rarepair/rocketeer/README.md

# rocketeer
A model rocket ignitor with adjustable current source and continuity checking. Capable of sourcing up to 10A from 4S lithium pack.
