rarepair/rocketeer/cad/Silkscreen Art/moon_art.bmp

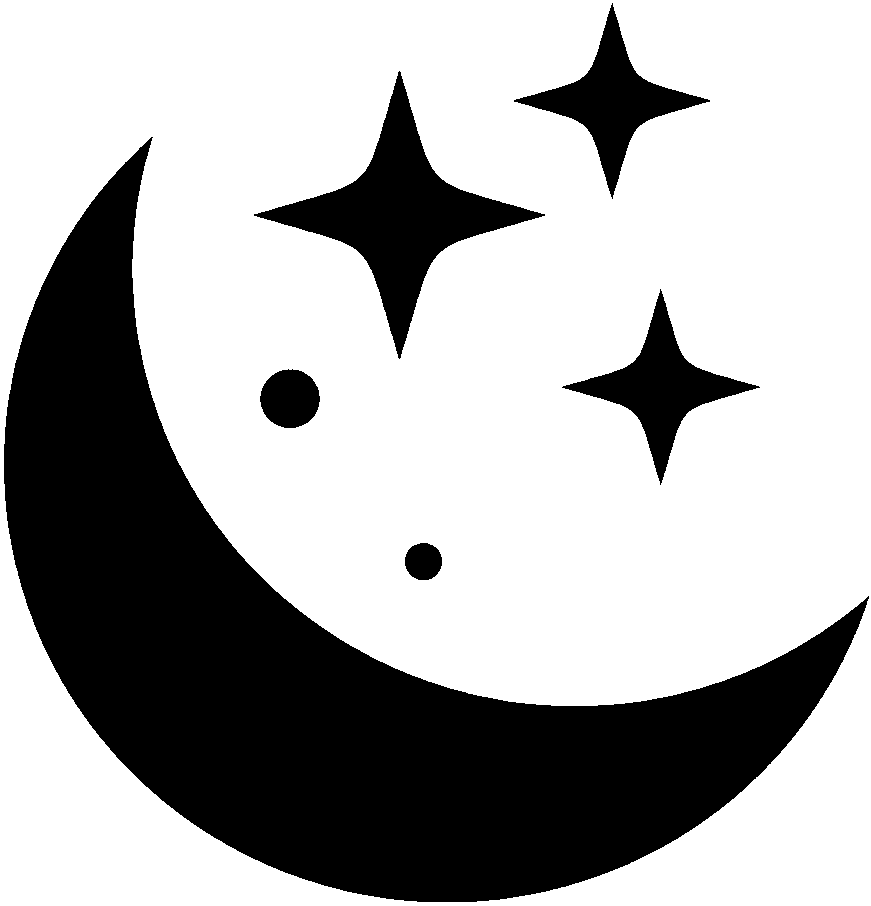
cad/Silkscreen Art/moon_art.bmp
