rarepair/rocketeer/cad/Silkscreen Art/rocket_art.bmp

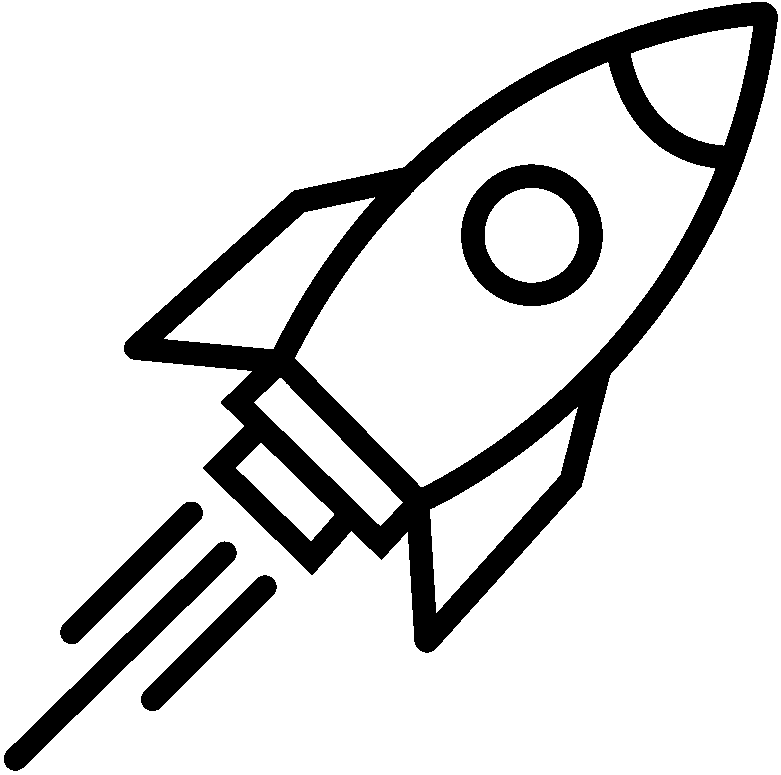
cad/Silkscreen Art/rocket_art.bmp
