rarepair/rocketeer/cad/Silkscreen Art/saturn_art.bmp

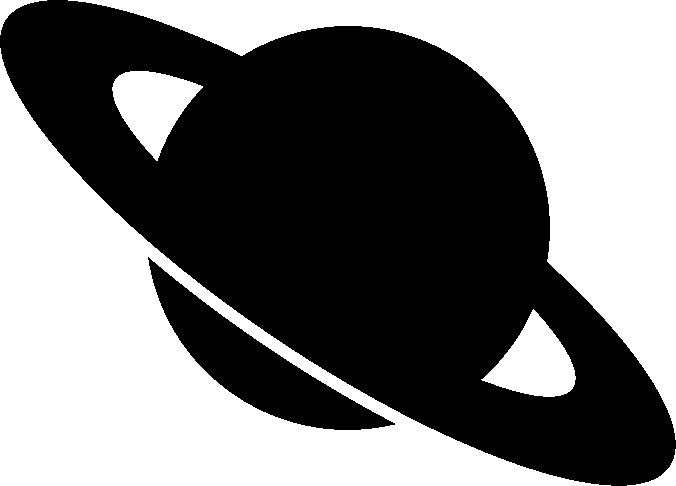
cad/Silkscreen Art/saturn_art.bmp
