rarepair/rocketeer/cad/Silkscreen Art/shooting_star_art.bmp

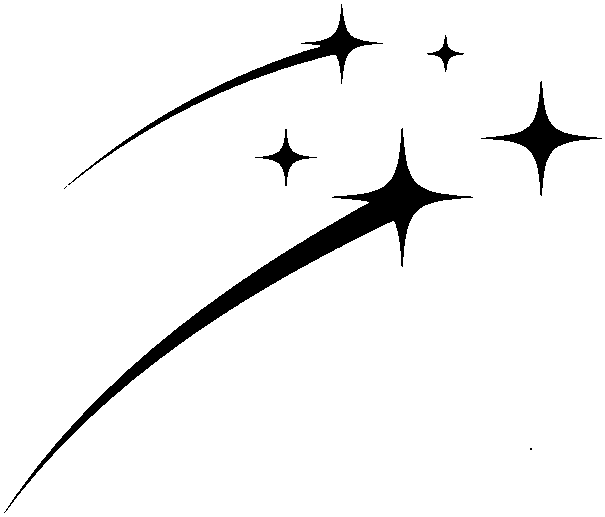
cad/Silkscreen Art/shooting_star_art.bmp
