rarepair/rocketeer/cad/Silkscreen Art/stars_art.bmp

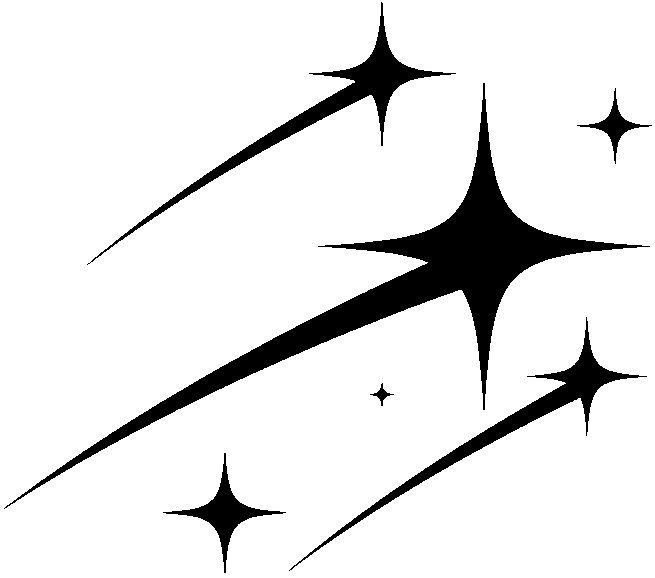
cad/Silkscreen Art/stars_art.bmp
