rarepair/rocketeer/bom/Bill of Materials-Rocket_Engine_Igniter.xlsx

Designator | Manufacturer | Part Number | LibRef | Quantity
U4 | Texas Instruments | SN74LVC1G17DCKR | SN74LVC1G17 | 1
U3 | Texas Instruments | LM7321MAX/NOPB | LM7321 | 1
U2 | Texas Instruments | TPS7A2425DBVR | TPS7A2425DBVR | 1
U1 | Monolithic Power Systems | MP2659-0000 | MP2659 | 1
SW3 | E-Switch | PV5S24019 | SW_PUSHBUTTON_PV5S24019 | 1
SW2 | Multicomp | MCR13-28A-01 | SW_TOGGLE_MCR13-28A-01 | 1
SW1 | Adam Tech | SW-R-K1-A | SW_KEYLOCK_SW-R-K1-A | 1
R28 | Stackpole Electronics Inc | RMCF0805FT1R00 | RES_0805_1R0 | 1
R23 | Stackpole Electronics | BR3FB50L0 | RES_BR3FB50L0_0R05_1% | 1
R21 | Bourns Inc. | PTV09A-4015F-B102 | POT_1K_PTV09A-4015F-B102 | 1
R20, R22, R26 |  |  | RES_0603_0R0 | 3
R17 | Vishay Dale | CRCW0805560RFKEAHP | RES_0805_560R | 1
R15 | Stackpole Electronics Inc | RMCF0603FT2K40 | RES_0603_2K4 | 1
R14, R16 | Stackpole Electronics Inc | RMCF0603FT1K00 | RES_0603_1K | 2
R10 | Stackpole Electronics Inc | RMCF0603FG15K0 | RES_0603_15K | 1
R9 |  |  | RES_0603_NOSTUFF | 1
R8, R13, R25 | Stackpole | RMCF0603FT100K | RES_0603_100K | 3
R6 | Stackpole Electronics Inc | RMCF0603FG150K | RES_0603_150K | 1
R5, R7 | Stackpole Electronics Inc. | RMCF0603FT95K3 | RES_0603_95K3 | 2
R3 | Stackpole Electronics Inc | RMCF0603FT330R | RES_0603_330R | 1
R2, R18, R24, R27 | Stackpole Electronics Inc | RMCF0603FT4K02 | RES_0603_4K02 | 4
R1, R4, R11, R12, R19 | Stackpole Electronics Inc | RMCF0603FT10K0 | RES_0603_10K | 5
Q5 | ANBON SEMICONDUCTOR (INT'L) LIMITED | AS2302 | NFET_AS2302 | 1
Q4 | Vishay | IRFP9140PBF | PFET_IRFP9140 | 1
Q3 | Diodes Incorporated | DMP610DL-7 | PFET_DMP610DL | 1
Q1, Q2 | Vishay Siliconix | SIS413DN-T1-GE3 | PFET_SIS413DN | 2
L1 | Pulse Electronics | AMRM00101040220MA1 | IND_AMRM00101040220MA1_22U0 | 1
J4 | Cal Test Electronics | CT3151SP-0 | CONN_BANANA_BLK_CT3151SP-2_1 | 1
J3 | Cal Test Electronics | CT3151SP-2 | CONN_BANANA_RED_CT3151SP-2 | 1
J2 | AMASS | XT30PW-M | CONN_PLUG_XT30PW-M | 1
J1 | CUI Devices | PJ-037A | CONN_BARREL_PLUG_PJ-037A | 1
D10 | ON Semiconductor | RB520S30T5G | DIODE_RB520S30T5G | 1
D7 | Würth Elektronik | 150141RS73100 | LED_RED_150141RS73100 | 1
D6 | Würth Elektronik | 150141GS73100 | LED_GREEN_150141GS73100 | 1
D5, D8, D9 | Diodes Incorporated | SMAJ20AQ-13-F | DIODE_TVS_20V_UNIDIR | 3
D4 | Würth Elektronik | 150141AS73100 | LED_AMBER_150141AS73100 | 1
D3 | Würth Elektronik | 150141BS73100 | LED_BLUE_150141BS73100 | 1
D2 | Diodes Incorporated | SMAJ33AQ-13-F | DIODE_TVS_33V_UNIDIR | 1
D1 | Diodes Incorporated | B240AE-13 | DIODE_SCHOTTKY_40V_2A | 1
C13 | Yageo | CC0805KKX5R5BB106 | CAP_0805_10uF | 1
C11 | Samsung Electro-Mechanics | CL10B103KB8NNNC | CAP_0603_10nF | 1
C10 | KYOCERA AVX | KGM15AR71H102KT | CAP_0603_1nF | 1
C9 | Samsung Electro-Mechanics | CL10B225KP8NNNC | CAP_0603_2.2uF | 1
C5, C12 | Samsung Electro-Mechanics | CL31A106MBHNNNE | CAP_1206_10uF | 2
C4, C8 | Samsung Electro-Mechanics | CL10B105KA8NNNC | CAP_0603_1uF | 2
C3 | Würth Elektronik | 860020572006 | CAP_RADIAL_47uF | 1
C2, C6, C7 | Samsung Electro-Mechanics | CL10B104KB8NNWC | CAP_0603_100nF | 3
C1 | Samsung Electro-Mechanics | CL31B225KBHNFNE | CAP_1206_2.2uF | 1
