rarepair/rocketeer/stp/Rocket_Engine_Igniter.step

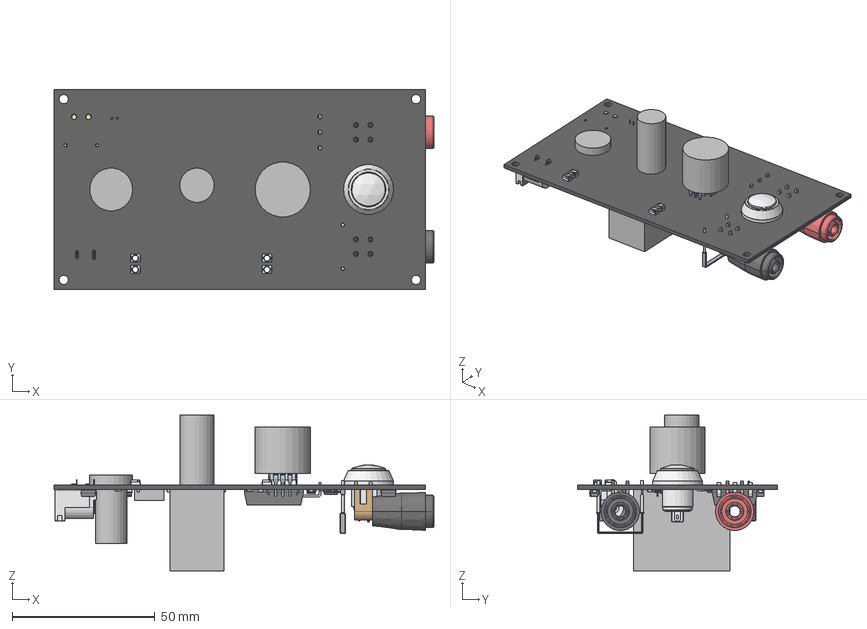
[picture p6: CAD file, 2025-01-13]
stp/Rocket_Engine_Igniter.step
132.9 x 70.0 x 54.4 mm
SOT-353
User Library-SOIC-8-1
User Library-SOT-23-5_pin_SOT_sot-23-6_1 x 5
User Library-SOT-23-5_body_sot23-6_1
Extruded x 3
SW_PUSHBUTTON_PV5S24019
RES_0603 x 22
RES_BR3FB50L0_0R05_1%
RES_0805 x 3
SOT-23-3 x 2
PFET_POWERPAK_1212-8 x 2
CONN_BANANA_BLK_CT3151SP-0
CONN_BANANA_RED_CT3151SP-2
CONN_PLUG_XT30PW-M
CONN_BARREL_PLUG_PJ-037A
SOD-523
FilletPin1 x 5
FilletPin2 x 5
CAP_1206 x 3
CAP_0603 x 8
POT_PTV09A-4x15F-xxxx
CAP_RADIAL_5MMx11MM
housing x 4
cover x 4
base x 8
