rarepair/rocketeer/sch/Rocket_Engine_Igniter.pdf

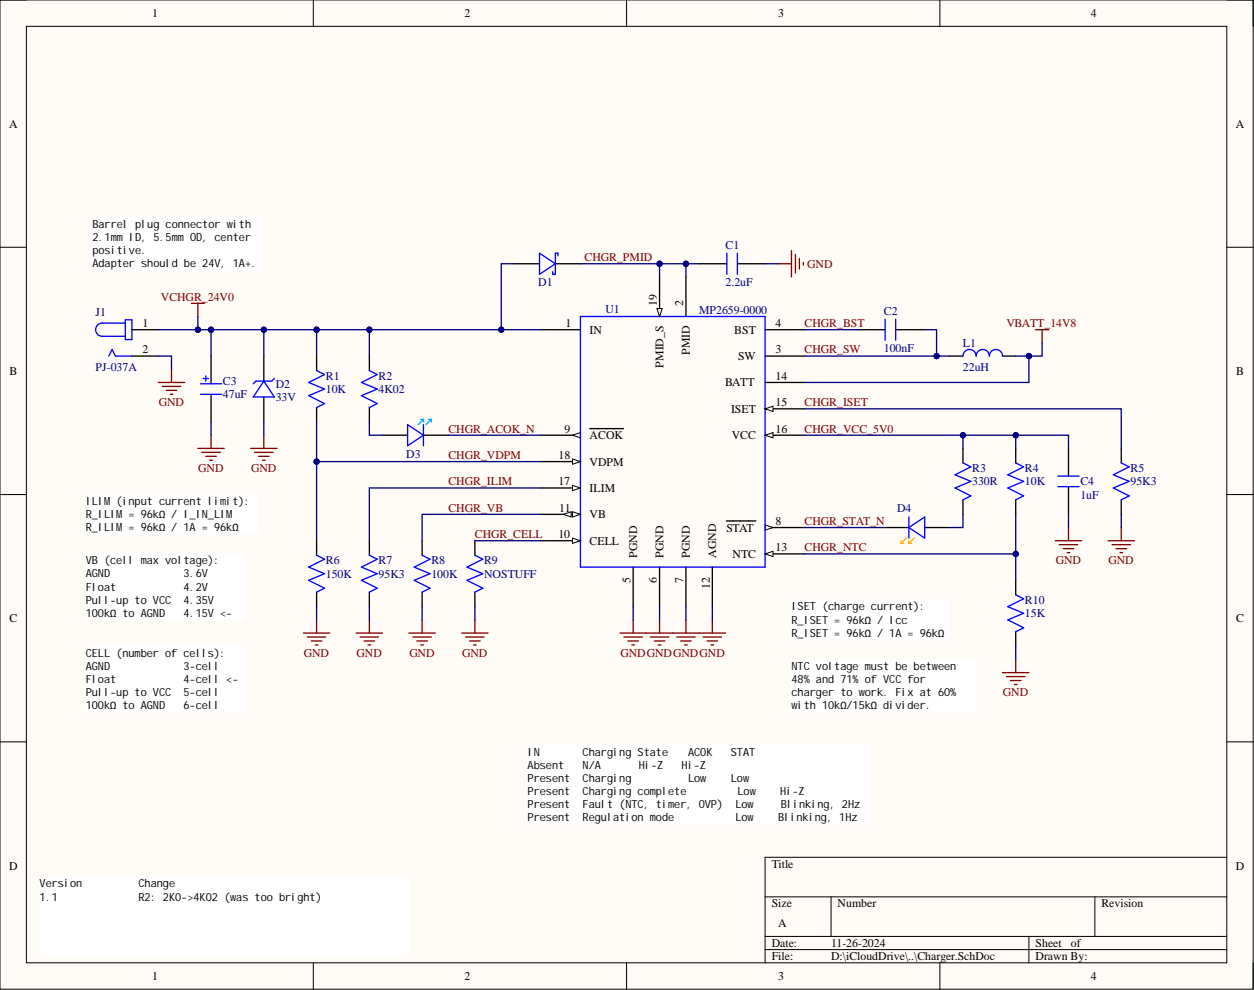
[picture p7: page 1]

Barrel plug connector with
2.1mm ID, 5.5mm OD, center
positive.
Adapter should be 24V, 1A+.

3 | CHGR_SW 100nF

CHGR_ILIM | | ILIM 17

CHGR_VB | 1 1

CHGR_CELL | | CELL 10

VB (cell max voltage):
Pull-up to VCC 4.35V

CELL (number of cells):
Pull-up to VCC 5-cell

NTC voltage must be between
48% and 71% of VCC for
charger to work. Fix at 60%
with 10k

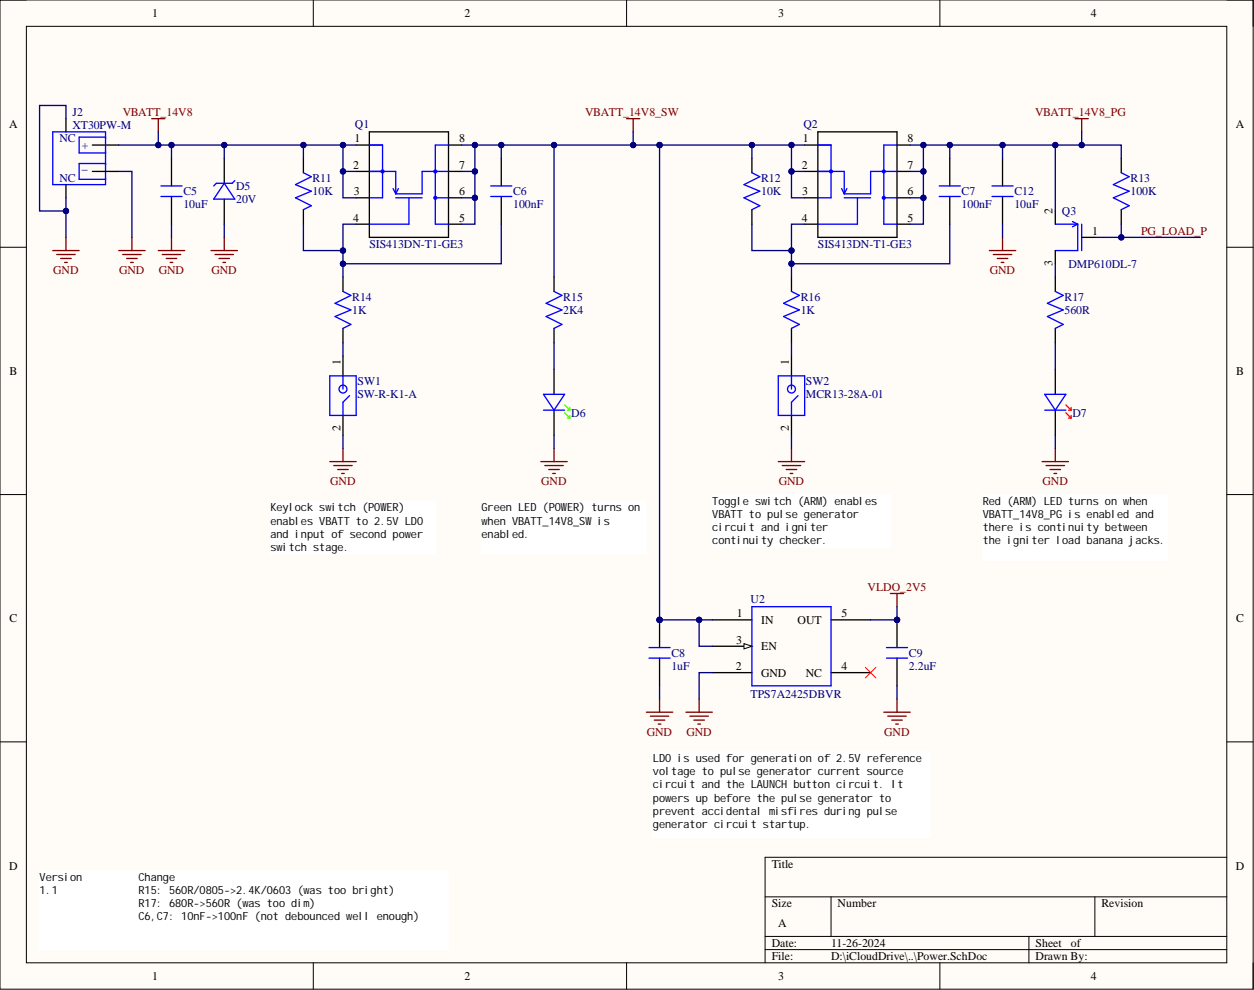
[picture p8: page 2]

Keylock switch (POWER)
enables VBATT to 2.5V LDO
and input of second power
switch stage.

Green LED (POWER) turns on
when VBATT_14V8_SW is
enabled.

Toggle switch (ARM) enables
VBATT to pulse generator
circuit and igniter
continuity checker.

Red (ARM) LED turns on when
VBATT_14V8_PG is enabled and
there is continuity between
the igniter load banana jacks.

LDO is used for generation of 2.5V reference
voltage to pulse generator current source
circuit and the LAUNCH button circuit. It
powers up before the pulse generator to
prevent accidental misfires during pulse
generator circuit startup.

R17: 680R->560R (was too dim)
C6,C7: 10nF->100nF (not debounced well enough)

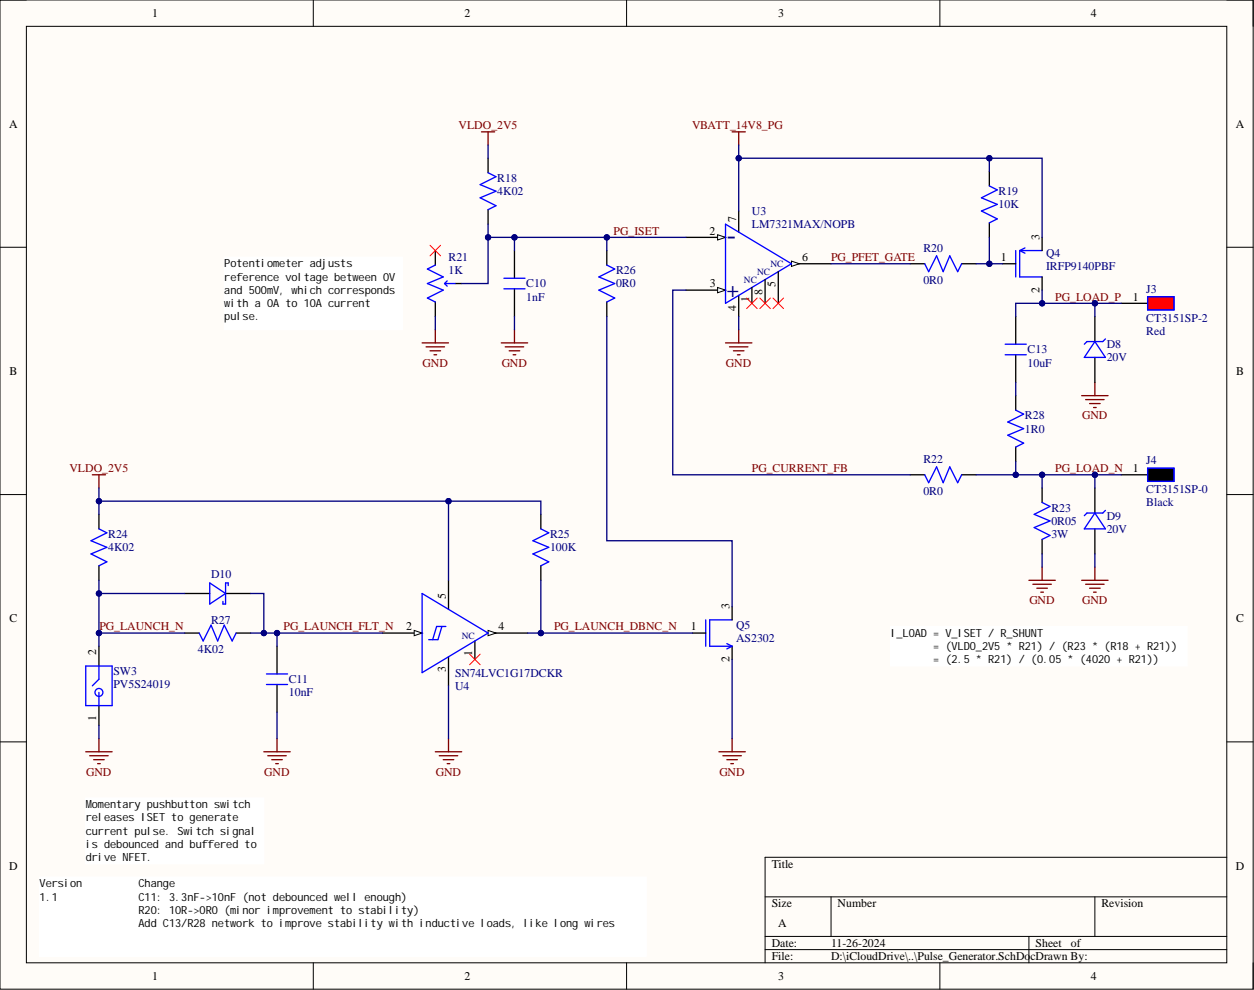
[picture p9: page 3]

Momentary pushbutton switch
releases ISET to generate
current pulse. Switch signal
is debounced and buffered to
drive NFET.

R20: 10R->0R0 (minor improvement to stability)
Add C13/R28 network to improve stability with inductive loads, like long wires
