rarepair/rocketeer/(list of files, drawings)

Other design files:
cad/Charger.SchDoc
cad/Power.SchDoc
cad/Pulse_Generator.SchDoc
cad/Rocket_Engine_Igniter.PcbDoc
cad/Rocket_Engine_Igniter.PrjPcb
